npgo22/APRL-ThermoComm-HW/ThermoBoard.kicad_pcb

## KiCad design ThermoBoard.kicad_pcb (2026-01-01)

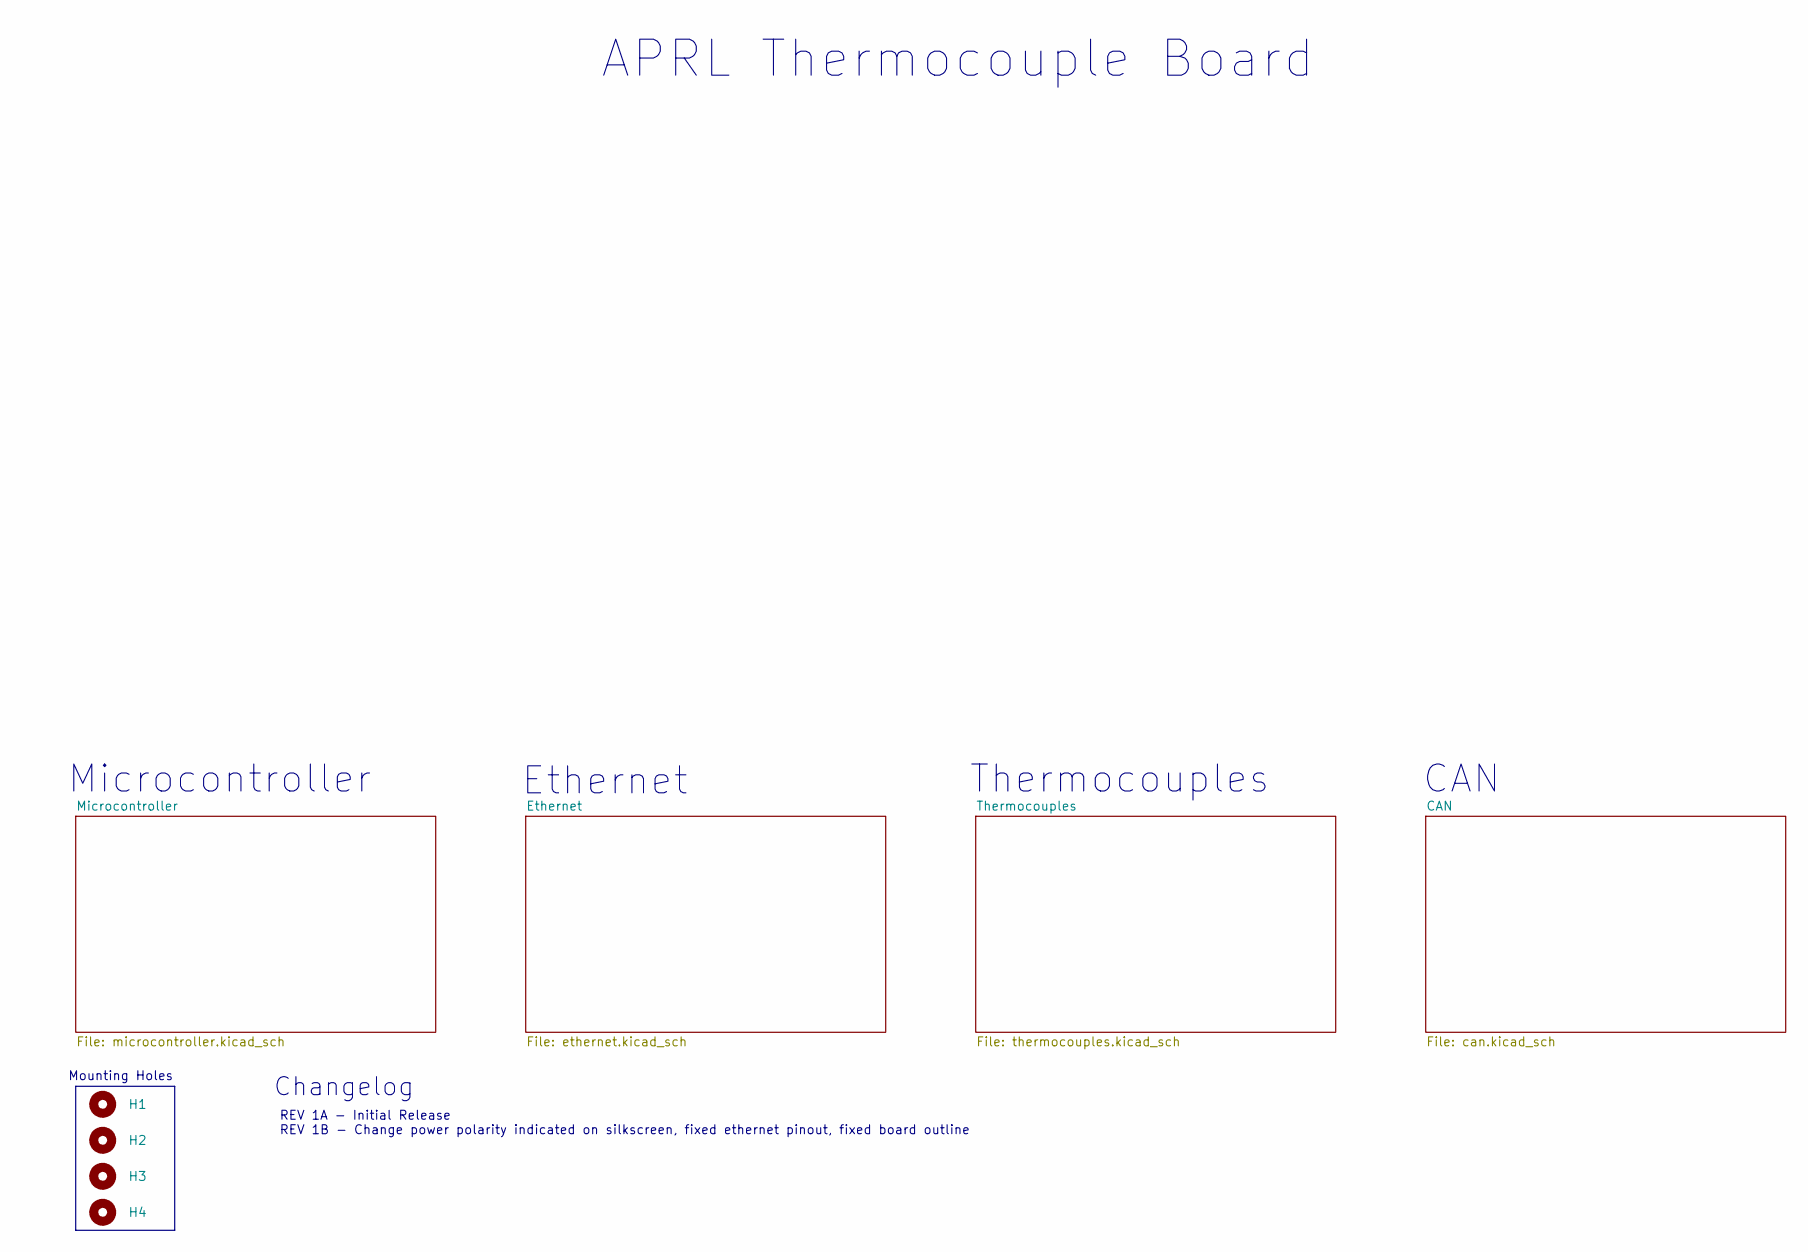
[picture p1: schematic ThermoBoard.kicad_sch, Thermocouple Board]

Parts:
H1, H2, H3, H4: MountingHole; MountingHole_3.2mm_M3

Notes on the sheet:
Changelog
APRL Thermocouple Board
REV 1A - Initial Release REV 1B - Change power polarity indicated on silkscreen, fixed ethernet pinout, fixed board outline
Mounting Holes
Thermocouples
Ethernet
Microcontroller
CAN

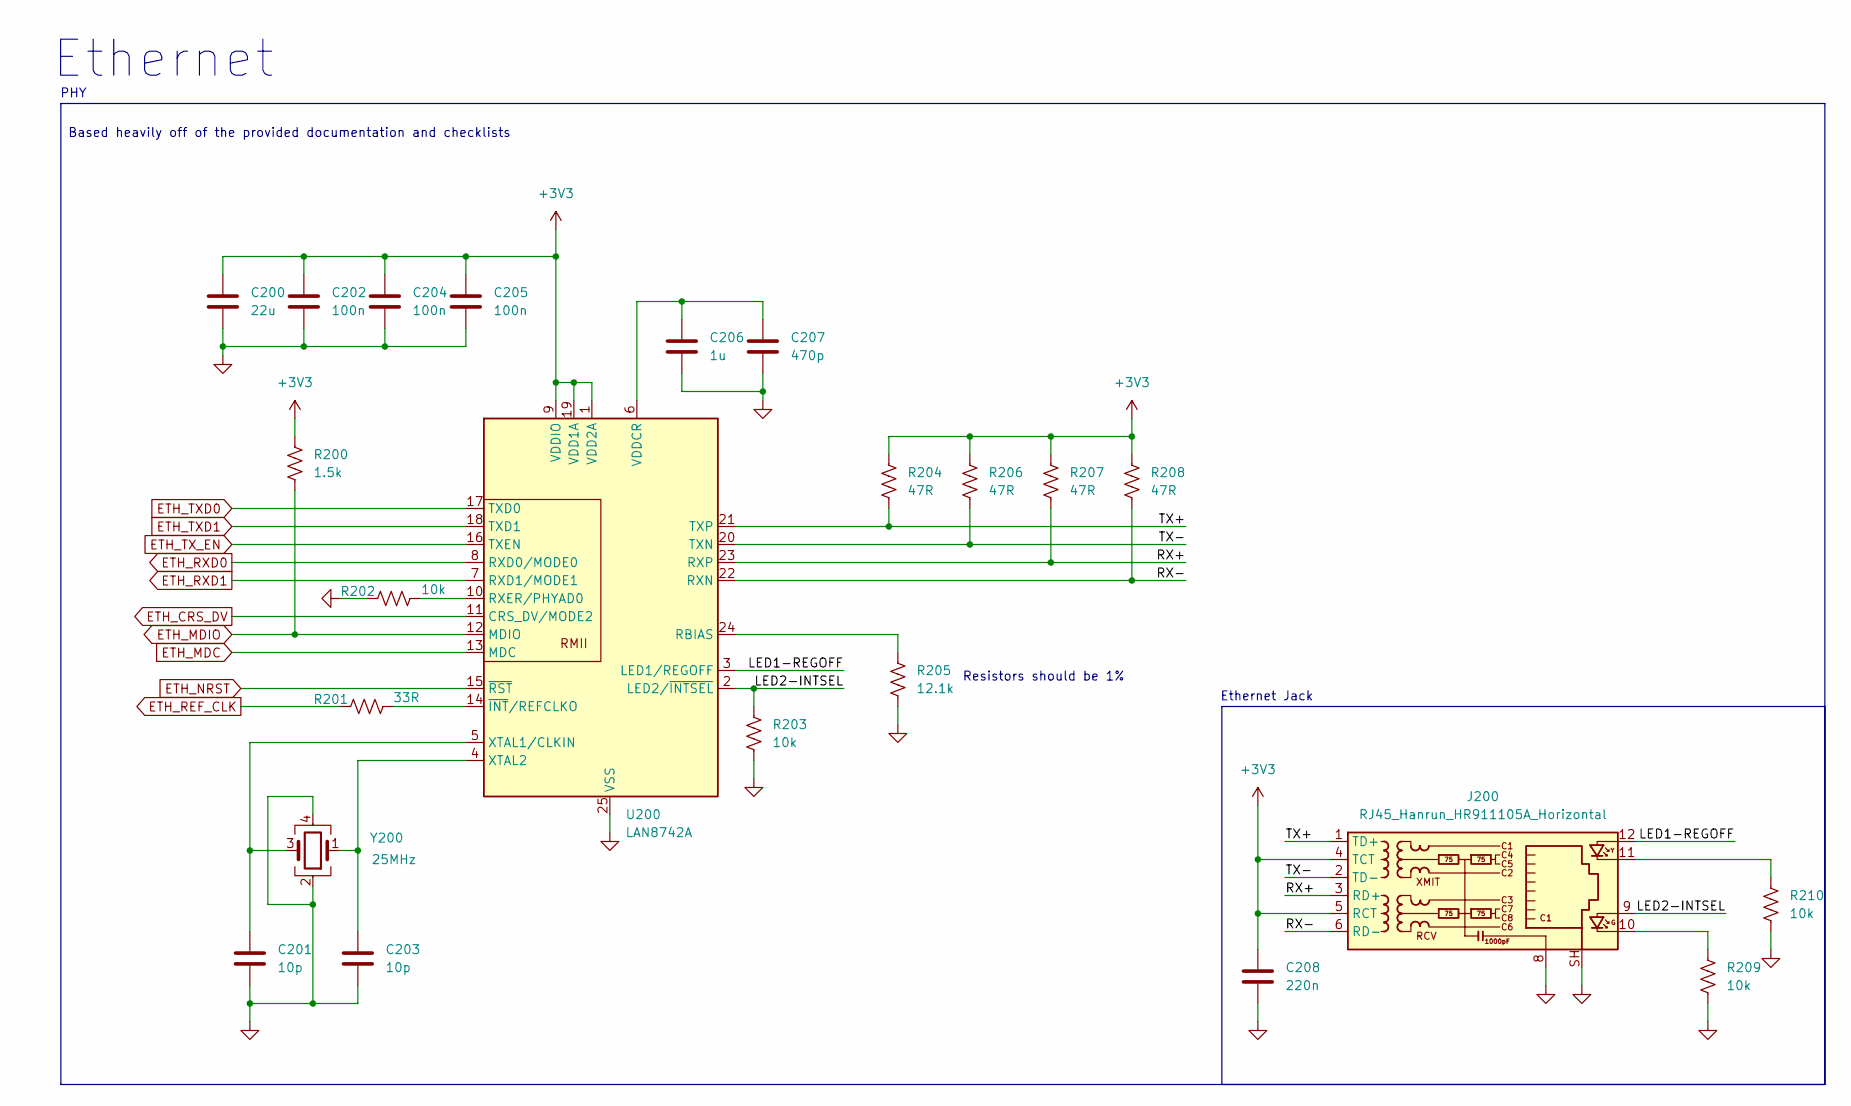
[picture p2: schematic ethernet.kicad_sch, Thermocouple Board]

Parts:
C200: 22u; C_0805_2012Metric; LCSC C602037
C201, C203: 10p; C_0402_1005Metric; LCSC C32949
C202, C204, C205: 100n; C_0402_1005Metric; LCSC C1525
C206: 1u; C_0402_1005Metric; LCSC C602037
C207: 470p; C_0402_1005Metric; LCSC C602037
C208: 220n; C_0402_1005Metric; LCSC C1525
J200: RJ45_Hanrun_HR911105A_Horizontal; LCSC C12074
R200: 1.5k; R_0402_1005Metric; LCSC C60490
R201: 33R; R_0402_1005Metric; LCSC C138002
R202, R203: 10k; R_0402_1005Metric; LCSC C60490
R204, R206, R207, R208: 47R; R_0402_1005Metric; LCSC C87044
R205: 12.1k; R_0402_1005Metric; LCSC C25852
R209, R210: 10k; R_0402_1005Metric; LCSC C105875
U200: LAN8742A; VQFN-24-1EP_4x4mm_P0.5mm_EP2.5x2.5mm_ThermalVias
Y200: 25MHz; CRYSTAL-SMD_4P-L2.0-W1.6-BL; LCSC C5765970

Connections:
+3V3: C200.1, C202.1, C204.1, C205.1, C208.1, J200.4 (TCT), J200.5 (RCT), R200.1, R204.1, R206.1, R207.1, R208.1, U200.1 (VDD2A), U200.9 (VDDIO), U200.19 (VDD1A); also elsewhere on the board
/Ethernet/LED1-REGOFF: J200.12, U200.3 (LED1/REGOFF)
/Ethernet/LED2-INTSEL: J200.9, R203.1, U200.2 (LED2/~INTSEL)
/Ethernet/RX+: J200.3 (RD+), R207.2, U200.23 (RXP)
/Ethernet/RX-: J200.6 (RD-), R208.2, U200.22 (RXN)
/Ethernet/TX+: J200.1 (TD+), R204.2, U200.21 (TXP)
/Ethernet/TX-: J200.2 (TD-), R206.2, U200.20 (TXN)
ETH_CRS_DV: U200.11 (CRS_DV/MODE2); also elsewhere on the board
ETH_MDC: U200.13 (MDC); also elsewhere on the board
ETH_MDIO: R200.2, U200.12 (MDIO); also elsewhere on the board
ETH_NRST: U200.15 (~RST); also elsewhere on the board
ETH_REF_CLK: R201.1; also elsewhere on the board
ETH_RXD0: U200.8 (RXD0/MODE0); also elsewhere on the board
ETH_RXD1: U200.7 (RXD1/MODE1); also elsewhere on the board
ETH_TXD0: U200.17 (TXD0); also elsewhere on the board
ETH_TXD1: U200.18 (TXD1); also elsewhere on the board
ETH_TX_EN: U200.16 (TXEN); also elsewhere on the board
GND: C200.2, C201.2, C202.2, C203.2, C204.2, C205.2, C206.2, C207.2, C208.2, J200.8, J200.SH, R202.1, R203.2, R205.2, R209.2, R210.2, U200.25 (VSS), Y200.2, Y200.4; also elsewhere on the board
unnamed: J200.10, R209.1
unnamed: J200.11, R210.1
unnamed: R205.1, U200.24 (RBIAS)
unnamed: R202.2, U200.10 (RXER/PHYAD0)
unnamed: C206.1, C207.1, U200.6 (VDDCR)
unnamed: C201.1, U200.5 (XTAL1/CLKIN), Y200.3
unnamed: C203.1, U200.4 (XTAL2), Y200.1
unnamed: R201.2, U200.14 (~INT/REFCLKO)

Notes on the sheet:
Ethernet
Resistors should be 1%
Ethernet Jack
PHY
Based heavily off of the provided documentation and checklists

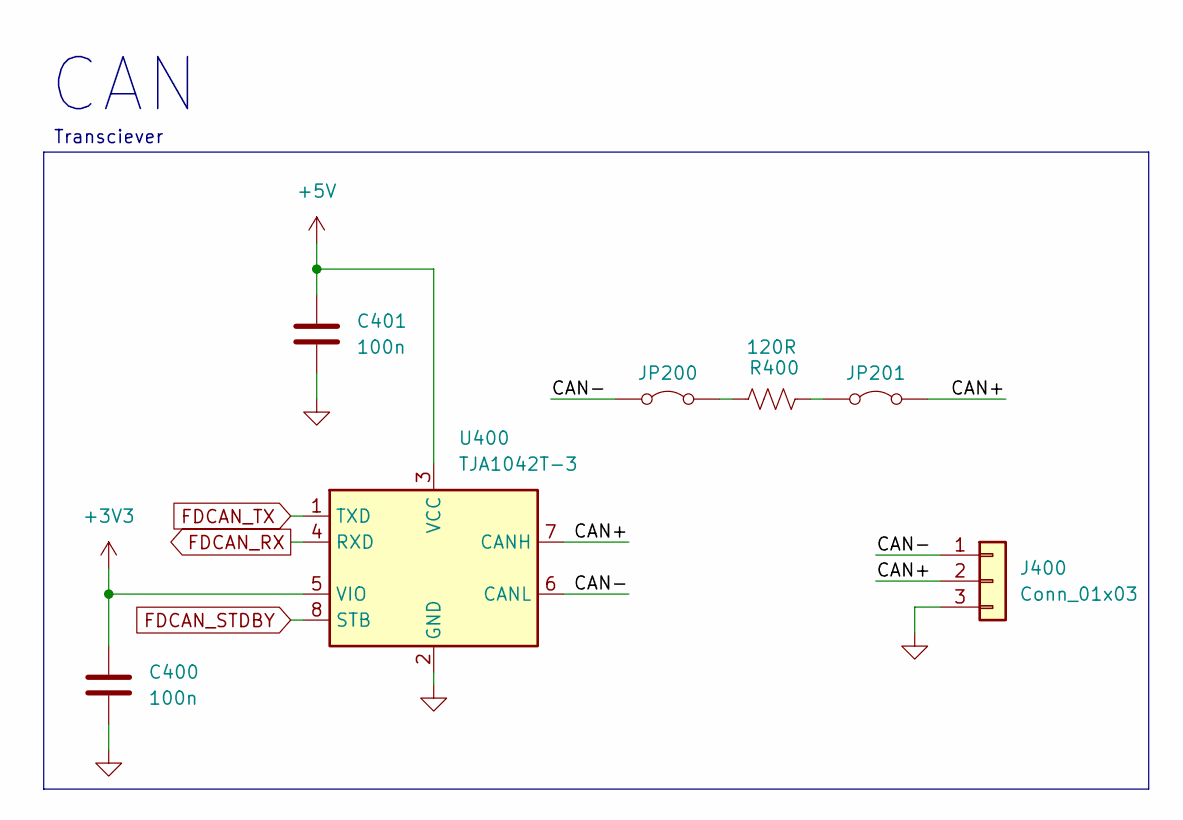
[picture p3: schematic can.kicad_sch, Thermocouple Board]

Parts:
C400, C401: 100n; C_0402_1005Metric; LCSC C1525
J400: Conn_01x03; PinHeader_1x03_P2.54mm_Vertical; LCSC C2337
JP200, JP201: Jumper_2_Bridged; PinHeader_1x02_P2.54mm_Vertical; LCSC C2337
R400: 120R; R_0402_1005Metric; LCSC C137954
U400: TJA1042T-3; SOIC-8_3.9x4.9mm_P1.27mm; LCSC C22445414

Connections:
+3V3: C400.1, U400.5 (VIO); also elsewhere on the board
+5V: C401.1, U400.3 (VCC); also elsewhere on the board
/CAN/CAN+: J400.2, JP201.2 (B), U400.7 (CANH)
/CAN/CAN-: J400.1, JP200.1 (A), U400.6 (CANL)
FDCAN_RX: U400.4 (RXD); also elsewhere on the board
FDCAN_STDBY: U400.8 (STB); also elsewhere on the board
FDCAN_TX: U400.1 (TXD); also elsewhere on the board
GND: C400.2, C401.2, J400.3, U400.2 (GND); also elsewhere on the board
unnamed: JP200.2 (B), R400.1
unnamed: JP201.1 (A), R400.2

Notes on the sheet:
CAN
Transciever

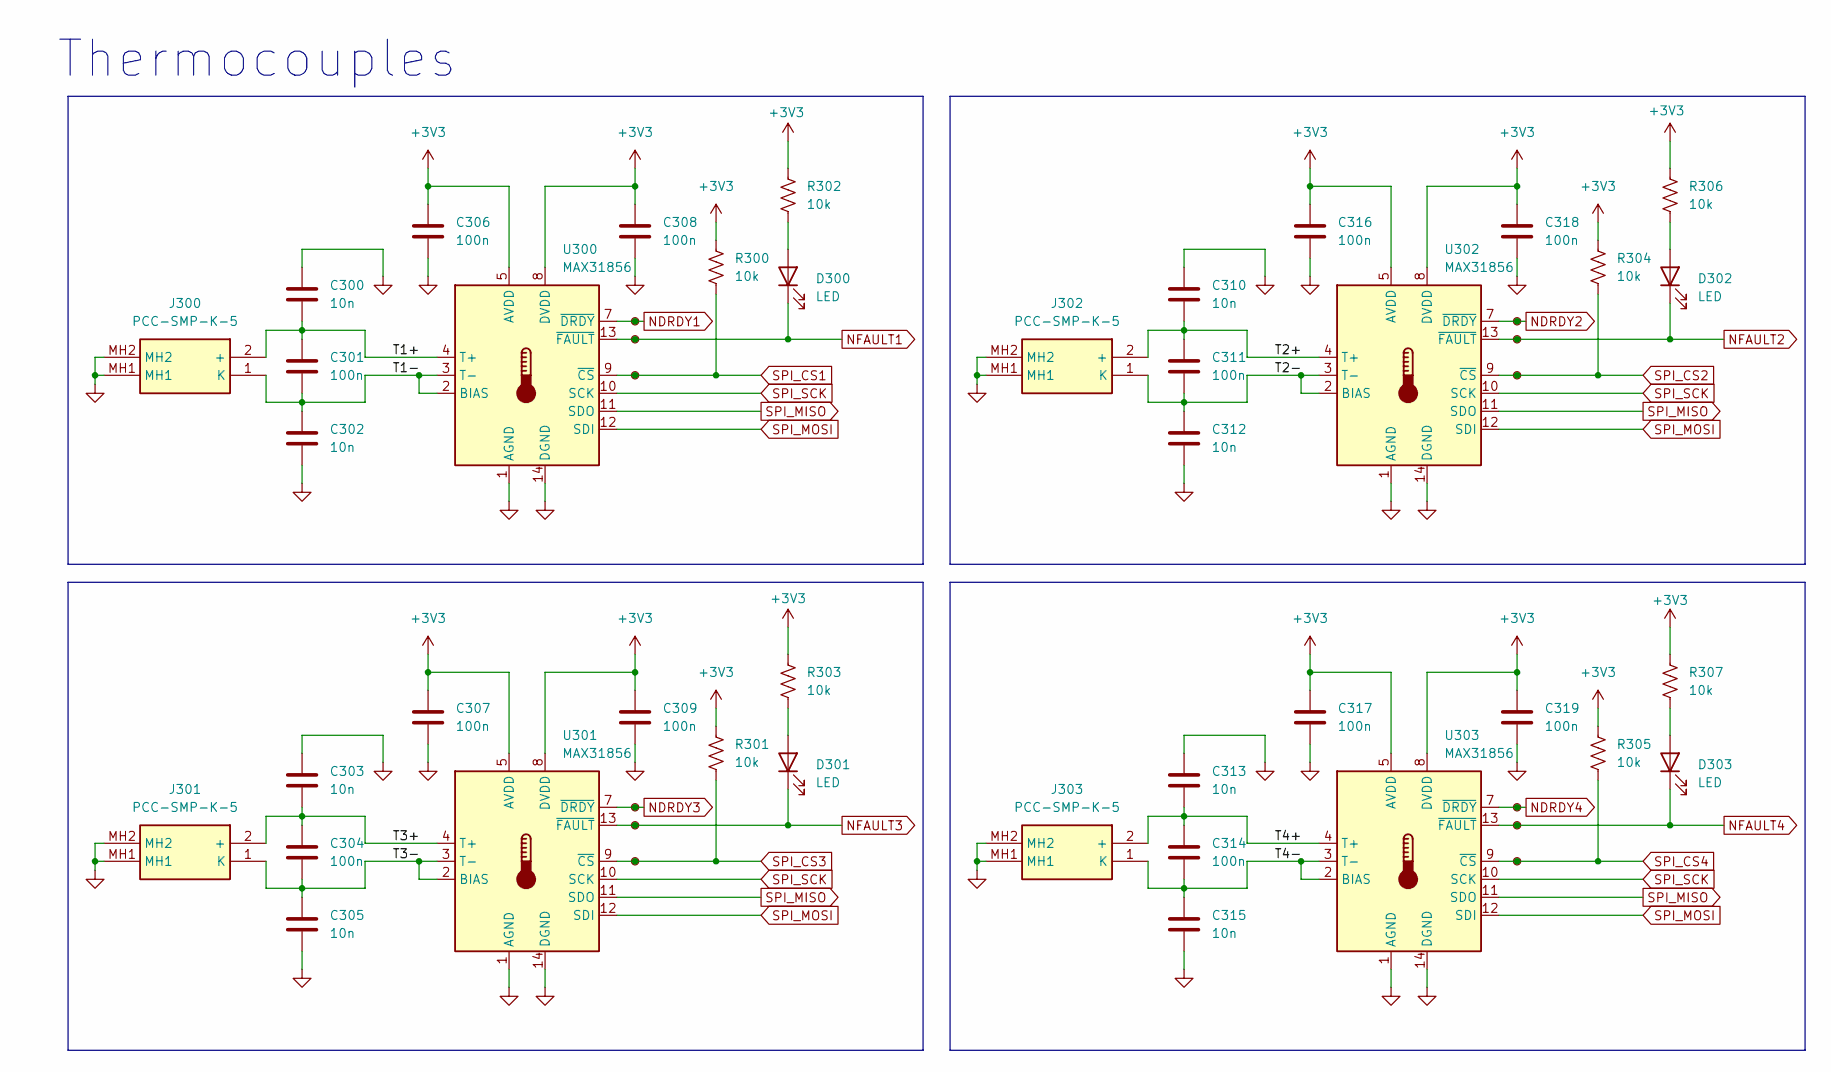
[picture p4: schematic thermocouples.kicad_sch, Thermocouple Board]

Parts:
C300, C302, C303, C305, C310, C312, C313, C315: 10n; C_0402_1005Metric; LCSC C15195
C301, C304, C306, C307, C308, C309, C311, C314, C316, C317, C318, C319: 100n; C_0402_1005Metric; LCSC C1525
D300, D301, D302, D303: LED; LED_0402_1005Metric; LCSC C21260817
J300, J301, J302, J303: PCC-SMP-K-5; PCCSMPK5; Manufacturer_Part_Number PCC-SMP-K-5
R300, R301, R304, R305: 10k; R_0402_1005Metric; LCSC C60490
R302, R303, R306, R307: 10k; R_0402_1005Metric; LCSC C105875
TP300, TP301, TP302, TP303, TP304, TP305, TP306, TP307, TP308, TP309, TP310, TP311: TestPoint_Small; TestPoint_Pad_D1.0mm
U300, U301, U302, U303: MAX31856; TSSOP-14_4.4x5mm_P0.65mm; LCSC C2653162

Connections:
+3V3: C306.1, C307.1, C308.1, C309.1, C316.1, C317.1, C318.1, C319.1, R300.1, R301.1, R302.1, R303.1, R304.1, R305.1, R306.1, R307.1, U300.5 (AVDD), U300.8 (DVDD), U301.5 (AVDD), U301.8 (DVDD), U302.5 (AVDD), U302.8 (DVDD), U303.5 (AVDD), U303.8 (DVDD); also elsewhere on the board
/Thermocouples/T1+: C300.2, C301.1, J300.2 (+), U300.4 (T+)
/Thermocouples/T1-: C301.2, C302.1, J300.1 (K), U300.2 (BIAS), U300.3 (T-)
/Thermocouples/T2+: C310.2, C311.1, J302.2 (+), U302.4 (T+)
/Thermocouples/T2-: C311.2, C312.1, J302.1 (K), U302.2 (BIAS), U302.3 (T-)
/Thermocouples/T3+: C303.2, C304.1, J301.2 (+), U301.4 (T+)
/Thermocouples/T3-: C304.2, C305.1, J301.1 (K), U301.2 (BIAS), U301.3 (T-)
/Thermocouples/T4+: C313.2, C314.1, J303.2 (+), U303.4 (T+)
/Thermocouples/T4-: C314.2, C315.1, J303.1 (K), U303.2 (BIAS), U303.3 (T-)
GND: C300.1, C302.2, C303.1, C305.2, C306.2, C307.2, C308.2, C309.2, C310.1, C312.2, C313.1, C315.2, C316.2, C317.2, C318.2, C319.2, J300.MH1, J300.MH2, J301.MH1, J301.MH2, J302.MH1, J302.MH2, J303.MH1, J303.MH2, U300.1 (AGND), U300.14 (DGND), U301.1 (AGND), U301.14 (DGND), U302.1 (AGND), U302.14 (DGND), U303.1 (AGND), U303.14 (DGND); also elsewhere on the board
NDRDY1: TP300.1, U300.7 (~DRDY); also elsewhere on the board
NDRDY2: TP306.1, U302.7 (~DRDY); also elsewhere on the board
NDRDY3: TP303.1, U301.7 (~DRDY); also elsewhere on the board
NDRDY4: TP309.1, U303.7 (~DRDY); also elsewhere on the board
NFAULT1: D300.1 (K), TP301.1, U300.13 (~FAULT); also elsewhere on the board
NFAULT2: D302.1 (K), TP307.1, U302.13 (~FAULT); also elsewhere on the board
NFAULT3: D301.1 (K), TP304.1, U301.13 (~FAULT); also elsewhere on the board
NFAULT4: D303.1 (K), TP310.1, U303.13 (~FAULT); also elsewhere on the board
unnamed: D300.2 (A), R302.2
unnamed: D301.2 (A), R303.2
unnamed: D302.2 (A), R306.2
unnamed: D303.2 (A), R307.2
SPI_CS1: R300.2, TP302.1, U300.9 (~CS); also elsewhere on the board
SPI_CS2: R304.2, TP308.1, U302.9 (~CS); also elsewhere on the board
SPI_CS3: R301.2, TP305.1, U301.9 (~CS); also elsewhere on the board
SPI_CS4: R305.2, TP311.1, U303.9 (~CS); also elsewhere on the board
SPI_MISO: U300.11 (SDO), U301.11 (SDO), U302.11 (SDO), U303.11 (SDO); also elsewhere on the board
SPI_MOSI: U300.12 (SDI), U301.12 (SDI), U302.12 (SDI), U303.12 (SDI); also elsewhere on the board
SPI_SCK: U300.10 (SCK), U301.10 (SCK), U302.10 (SCK), U303.10 (SCK); also elsewhere on the board

Notes on the sheet:
Thermocouples

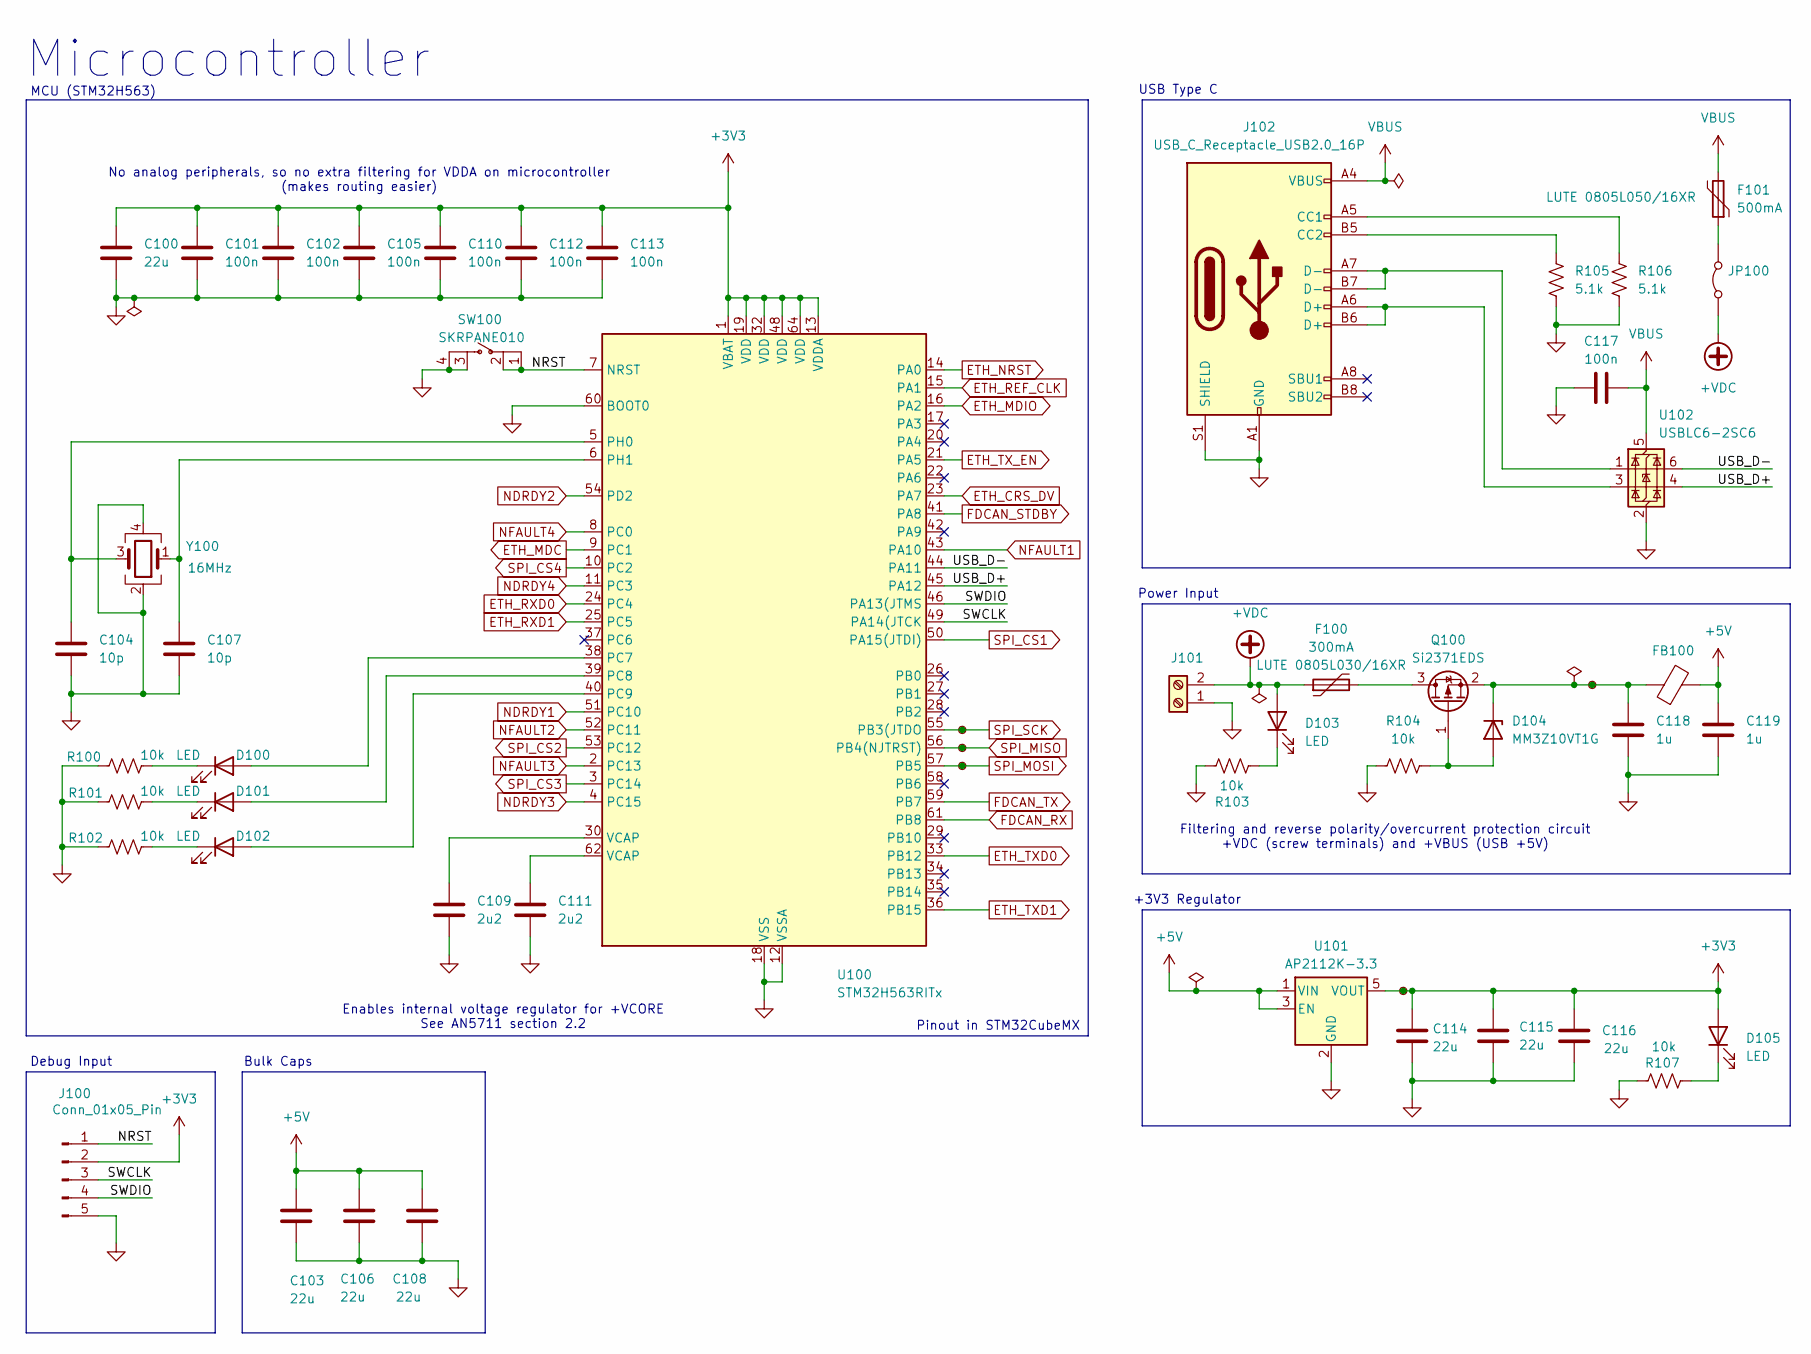
[picture p5: schematic microcontroller.kicad_sch, Thermocouple Board]

Parts:
C100, C103, C106, C108, C114, C115, C116: 22u; C_0805_2012Metric; LCSC C602037
C101, C102, C105, C110, C112, C113, C117: 100n; C_0402_1005Metric; LCSC C1525
C104, C107: 10p; C_0402_1005Metric; LCSC C32949
C109, C111: 2u2; C_0402_1005Metric; LCSC C170151
C118, C119: 1u; C_0402_1005Metric; LCSC C15849
D100, D101, D102, D103, D105: LED; LED_0402_1005Metric; LCSC C965793
D104: MM3Z10VT1G; SOD-323; LCSC C39057
F100: 300mA; Lute_16XR; Part LUTE 0805L030/16XR; LCSC C19193036
F101: 500mA; Lute_16XR; Part LUTE 0805L050/16XR; LCSC C22435898
FB100: FerriteBead; LSMGA160808T601RG
J100: Conn_01x05_Pin; PinHeader_1x05_P2.54mm_Vertical; LCSC C2337
J101: Screw_Terminal_01x02; TerminalBlock_Phoenix_MPT-0,5-2-2.54_1x02_P2.54mm_Horizontal; LCSC C3029316
J102: USB_C_Receptacle_USB2.0_16P; USB_C_Receptacle_HRO_TYPE-C-31-M-12; LCSC C165948
JP100: Jumper_2_Bridged; PinHeader_1x02_P2.54mm_Vertical; LCSC C2337
Q100: Si2371EDS; SOT-23; LCSC C467897
R100, R101, R102, R103, R107: 10k; R_0402_1005Metric; LCSC C105875
R104: 10k; R_0402_1005Metric; LCSC C60490
R105, R106: 5.1k; R_0402_1005Metric; LCSC C105873
SW100: SKRPANE010; SW-SMD_4P-L4.2-W3.2-P2.15-LS4.6-2; LCSC C2909692
TP100, TP101, TP102, TP104, TP105: TestPoint_Small; TestPoint_Pad_D1.0mm
U100: STM32H563RITx; LQFP-64_10x10mm_P0.5mm; LCSC C20619634
U101: AP2112K-3.3; SOT-23-5; LCSC C51118
U102: USBLC6-2SC6; SOT-23-6; LCSC C7519
Y100: 16MHz; CRYSTAL-SMD_4P-L2.0-W1.6-BL; LCSC C2901668

Connections:
+3V3: C100.1, C101.1, C102.1, C105.1, C110.1, C112.1, C113.1, C114.2, C115.2, C116.2, D105.2 (A), J100.2, TP104.1, U100.1 (VBAT), U100.13 (VDDA), U100.19 (VDD), U100.32 (VDD), U100.48 (VDD), U100.64 (VDD), U101.5 (VOUT); also elsewhere on the board
+5V: C103.2, C106.2, C108.2, C119.1, FB100.2, U101.1 (VIN), U101.3 (EN); also elsewhere on the board
+VDC: D103.2 (A), F100.1, J101.2, JP100.1 (A)
/Microcontroller/NRST: J100.1, SW100.1, SW100.2, U100.7 (NRST)
/Microcontroller/SWCLK: J100.3, U100.49 (PA14(JTCK)
/Microcontroller/SWDIO: J100.4, U100.46 (PA13(JTMS)
/Microcontroller/USB_D+: U100.45 (PA12), U102.4 (I/O2)
/Microcontroller/USB_D-: U100.44 (PA11), U102.6 (I/O1)
ETH_CRS_DV: U100.23 (PA7); also elsewhere on the board
ETH_MDC: U100.9 (PC1); also elsewhere on the board
ETH_MDIO: U100.16 (PA2); also elsewhere on the board
ETH_NRST: U100.14 (PA0); also elsewhere on the board
ETH_REF_CLK: U100.15 (PA1); also elsewhere on the board
ETH_RXD0: U100.24 (PC4); also elsewhere on the board
ETH_RXD1: U100.25 (PC5); also elsewhere on the board
ETH_TXD0: U100.33 (PB12); also elsewhere on the board
ETH_TXD1: U100.36 (PB15); also elsewhere on the board
ETH_TX_EN: U100.21 (PA5); also elsewhere on the board
FDCAN_RX: U100.61 (PB8); also elsewhere on the board
FDCAN_STDBY: U100.41 (PA8); also elsewhere on the board
FDCAN_TX: U100.59 (PB7); also elsewhere on the board
GND: C100.2, C101.2, C102.2, C103.1, C104.2, C105.2, C106.1, C107.2, C108.1, C109.2, C110.2, C111.2, C112.2, C113.2, C114.1, C115.1, C116.1, C117.1, C118.2, C119.2, J100.5, J101.1, J102.A1 (GND), J102.A12 (GND), J102.B1 (GND), J102.B12 (GND), J102.S1 (SHIELD), R100.1, R101.1, R102.1, R103.2, R104.1, R105.2, R106.2, R107.1, SW100.3, SW100.4, U100.12 (VSSA), U100.18 (VSS), U100.31 (VSS), U100.47 (VSS), U100.60 (BOOT0), U100.63 (VSS), U101.2 (GND), U102.2 (GND), Y100.2, Y100.4; also elsewhere on the board
NDRDY1: U100.51 (PC10); also elsewhere on the board
NDRDY2: U100.54 (PD2); also elsewhere on the board
NDRDY3: U100.4 (PC15); also elsewhere on the board
NDRDY4: U100.11 (PC3); also elsewhere on the board
NFAULT1: U100.43 (PA10); also elsewhere on the board
NFAULT2: U100.52 (PC11); also elsewhere on the board
NFAULT3: U100.2 (PC13); also elsewhere on the board
NFAULT4: U100.8 (PC0); also elsewhere on the board
unnamed: C109.1, U100.30 (VCAP)
unnamed: C111.1, U100.62 (VCAP)
unnamed: D100.2 (A), U100.38 (PC7)
unnamed: D100.1 (K), R100.2
unnamed: D101.2 (A), U100.39 (PC8)
unnamed: D101.1 (K), R101.2
unnamed: D102.2 (A), U100.40 (PC9)
unnamed: D102.1 (K), R102.2
unnamed: D103.1 (K), R103.1
unnamed: D104.2 (A), Q100.1 (G), R104.2
unnamed: C118.1, D104.1 (K), FB100.1, Q100.2 (S), TP105.1
unnamed: D105.1 (K), R107.2
unnamed: J102.A5 (CC1), R106.1
unnamed: J102.B5 (CC2), R105.1
unnamed: J102.A6 (D+), J102.B6 (D+), U102.3 (I/O2)
unnamed: J102.A7 (D-), J102.B7 (D-), U102.1 (I/O1)
unnamed: F101.1, JP100.2 (B)
unnamed: F100.2, Q100.3 (D)
unnamed: C104.1, U100.5 (PH0), Y100.3
unnamed: C107.1, U100.6 (PH1), Y100.1
SPI_CS1: U100.50 (PA15(JTDI)); also elsewhere on the board
SPI_CS2: U100.53 (PC12); also elsewhere on the board
SPI_CS3: U100.3 (PC14); also elsewhere on the board
SPI_CS4: U100.10 (PC2); also elsewhere on the board
SPI_MISO: TP101.1, U100.56 (PB4(NJTRST)); also elsewhere on the board
SPI_MOSI: TP102.1, U100.57 (PB5); also elsewhere on the board
SPI_SCK: TP100.1, U100.55 (PB3(JTDO); also elsewhere on the board
VBUS: C117.2, F101.2, J102.A4 (VBUS), J102.A9 (VBUS), J102.B4 (VBUS), J102.B9 (VBUS), U102.5 (VBUS)

Notes on the sheet:
Microcontroller
Debug Input
Power Input
+3V3 Regulator
Pinout in STM32CubeMX
Enables internal voltage regulator for +VCORE See AN5711 section 2.2
No analog peripherals, so no extra filtering for VDDA on microcontroller (makes routing easier)
Bulk Caps
Filtering and reverse polarity/overcurrent protection circuit +VDC (screw terminals) and +VBUS (USB +5V)
USB Type C
MCU (STM32H563)

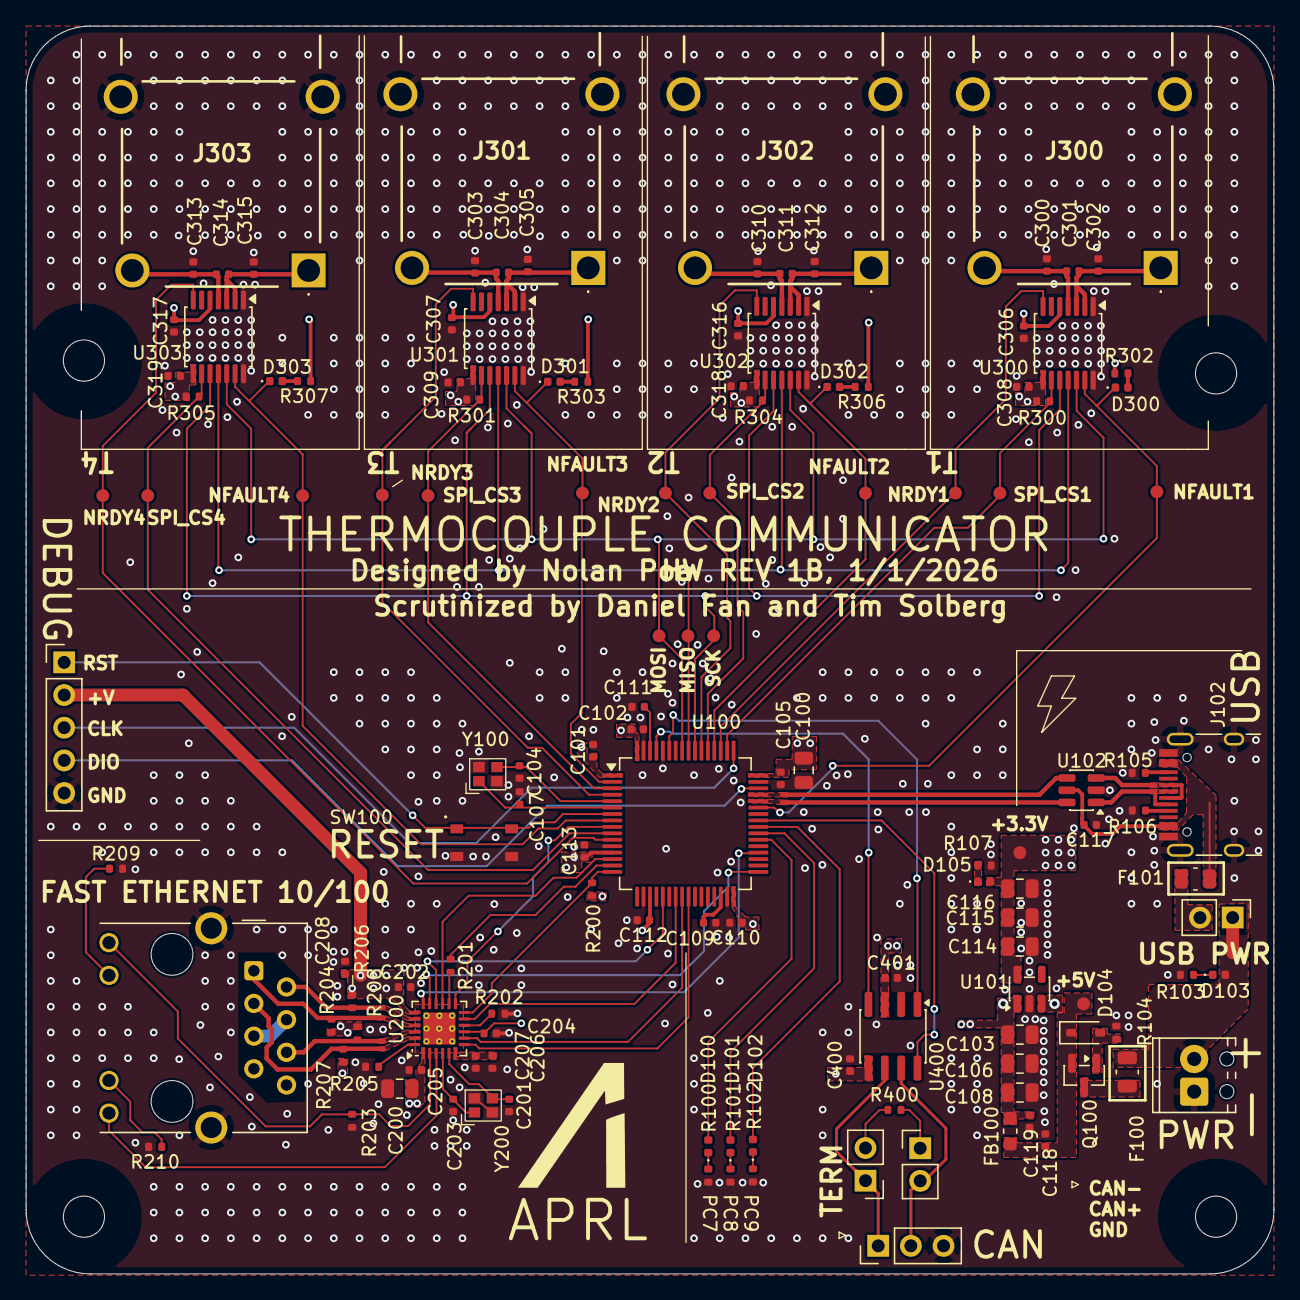
[picture p6: board ThermoBoard.kicad_pcb from above]

Board: 4 copper layers, 97.0 x 97.0 mm, 138 parts (0 on the bottom side), 88 nets.
