npgo22/APRL-ThermoComm-HW/(commit log)

2025-10-16 feat: First public release
    [ThermoBoard.csv, ThermoBoard.kicad_sch, can.kicad_sch, ethernet.kicad_sch, microcontroller.kicad_sch, thermocouples.kicad_sch]
2025-10-16 fix: Silkscreen overlaps
    [can.kicad_sch, ethernet.kicad_sch, microcontroller.kicad_sch, thermocouples.kicad_sch]
2025-10-16 chore: Prep for release
    [ThermoBoard.kicad_sch]
2026-01-01 Rev 1B - Fix silkscreen, board outline, ethernet pinout
    [ThermoBoard.kicad_pcb, ThermoBoard.kicad_sch, can.kicad_sch, ethernet.kicad_sch, microcontroller.kicad_sch, thermocouples.kicad_sch]
2026-01-01 fix DRC Problems
    [ThermoBoard.kicad_pcb]
